jaycordaro/WES207/teensy/readme.md

# Teensy files
Arudino IDE sketches to be run on the Teensy board. Contains both demos and component tests.

## Usage:
Install the Teensy plug in for the Arduino IDE here:
https://www.pjrc.com/teensy/td_download.html

Each folder runs as a standalone project. They can be opened by selecting the ino file from the File > Open... window. The project can be flashed to the Teesny board by pressing the arrow button after selecting the Teensy board from the dropdown menu next to the arrow.
