jaycordaro/WES207/matlab/audio_upsampler/readme.md

# Audio Upsampler
Upsamples the 16ksps audio to 44.1ksps to be used by Teensy audio library.

## Usage:
Run the MATLAB script, it will play the upsampled audio and export it to a wav file.
