jaycordaro/WES207/matlab/oqpsk/readme.md

# OPQSK Modulator
Specification for a 802.15.4 OPQSK modulator. This is currently done on the Atmel board but could also be implemented on the FPGA.

## Usage:
Run oqpsk.m in Matlab.
