jaycordaro/WES207/teensy/demos/readme.md

# Teensy demos
This folder contains demos that constitute usable deliverables.

## Usage:
Each folder contains its own demo to be run in the Aruduino IDE.
