jaycordaro/WES207/matlab/bpsk/tx/readme.md

# BPSK Demodulator
Used to simulate modulation of the pulse-shaped BPSK.

## Usage:
Run tx_bpsk.m in Matlab. This will produce output samples in tx_out with can then be used in the rx simulation.
