jaycordaro/WES207/presentations/In-Person Presentation The Northernites.pptx.pdf

802.15.4 Project

## The Northernites

Sam Weismuller, SangRyul “Eric” Pae, Jay Cordaro

MAS 2023 Students UC San Diego

## Introduction

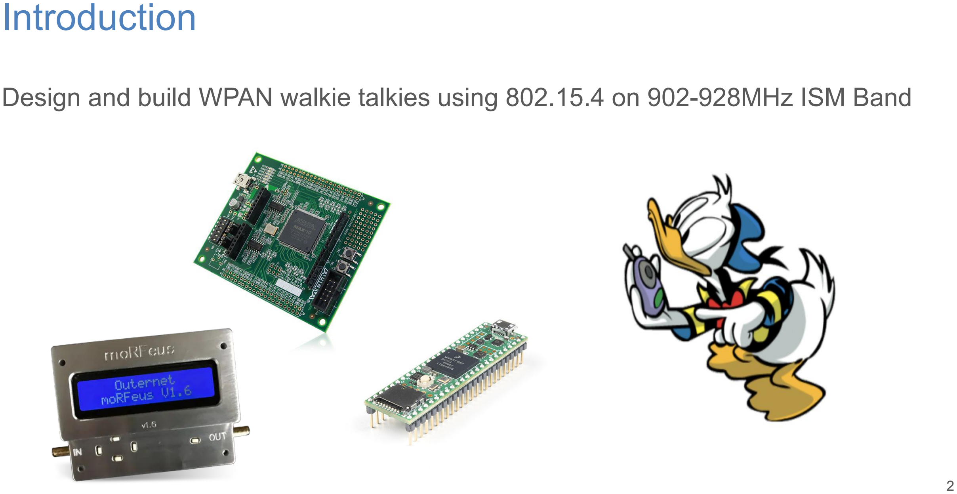
[picture p22: page 2]

Design and build WPAN walkie talkies using 802.15.4 on 902-928MHz ISM Band

### IEEE 802.15.4

- Simple standard to local-area networks
- Covers 900 MHz and 2.4 GHz ISM bands, among others
- Clause 13 defines Pulse-shaped BPSK and Clause 12 defines OQPSK mode
- Only Clause 13 BPSK is required in 900 MHz band
- Carrier-Sense Multiple Access with Collision Avoidance

Block Diagram

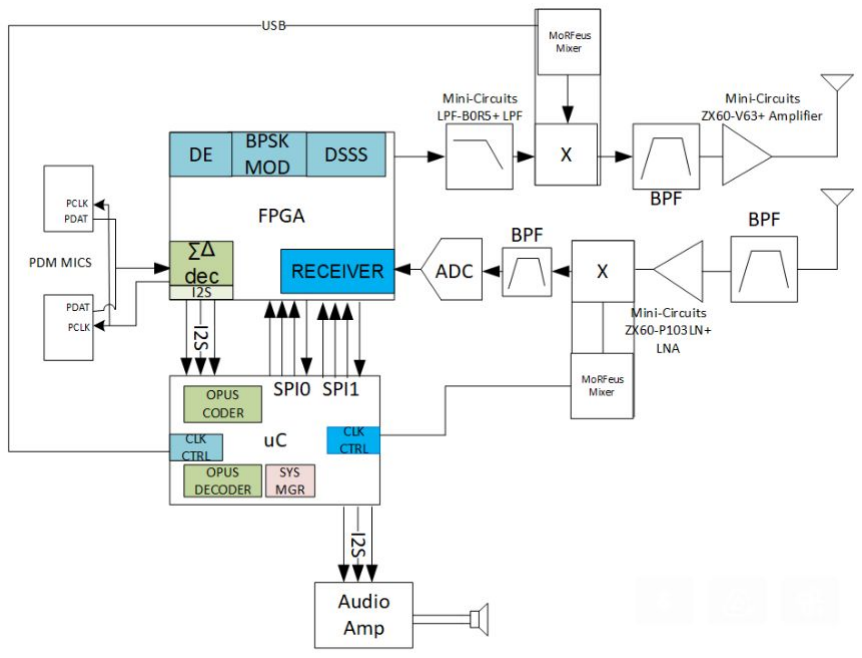
[picture p23: figure]

### Subsystems

- 3 subsystems:
- RF front end
- FPGA
- Microcontroller

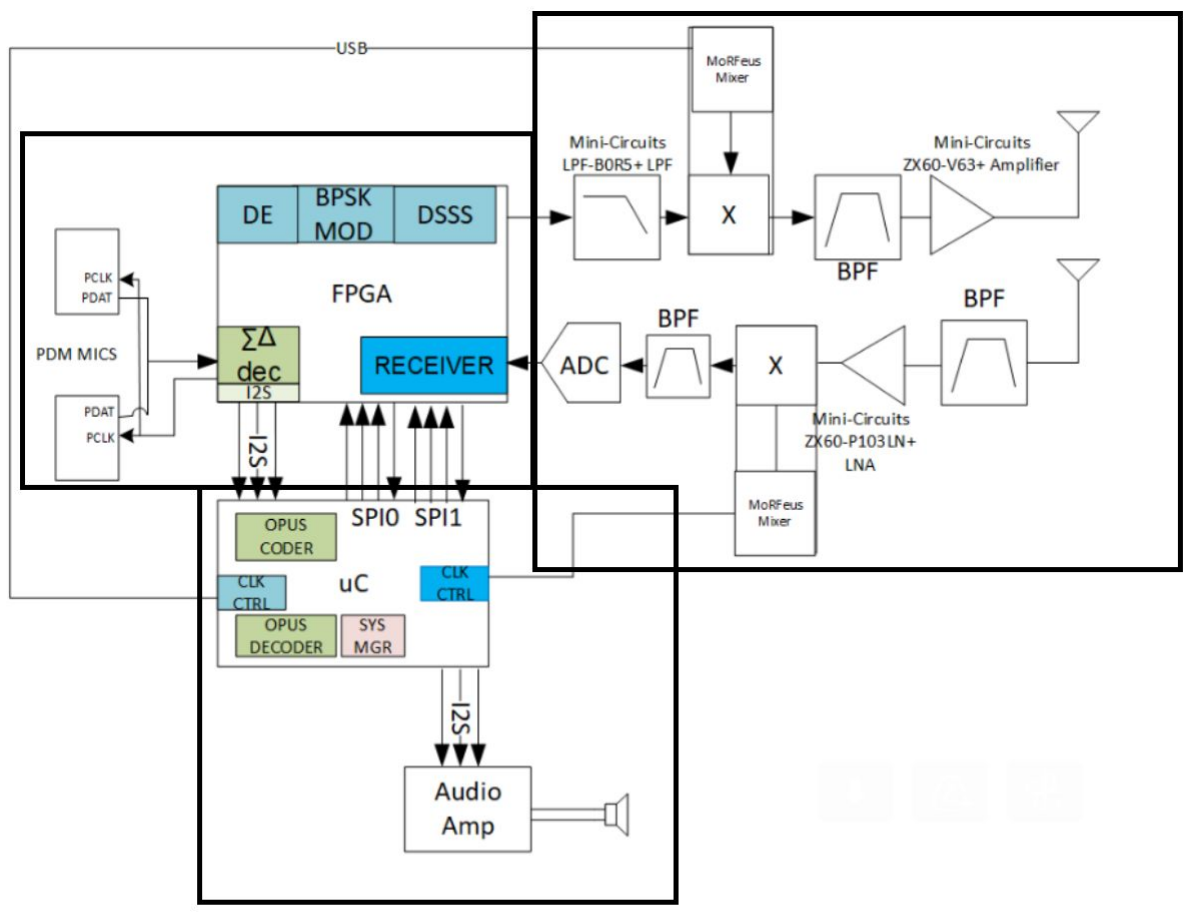
[picture p24: figure]

### Progress

Audio Front End/FPGA:

- Built floating point Matlab model of sigma-delta decimator, checked in (https://github.com/jaycordaro/WES207/tree/main/matlab/pdm)
- Captured PDM audio using test jig
- Wrote SystemVerilog code and test benches for SPI and I2S, checked in (https://github.com/jaycordaro/WES207/tree/main/rtl/audio_front_end)
- Floating point Matlab model of transmitter blocks, checked in (https://github.com/jaycordaro/WES207/tree/main/matlab/tx)
Microcontroller:
- Implemented Opus source coder demo reading/writing audio data from an SD card, checked in (https://github.com/jaycordaro/WES207/tree/main/teensy/encoder_test)
- Tested different bit error rates and code rates, checked in (https://github.com/jaycordaro/WES207/tree/main/matlab/opus_test)
RF Front End:
- Decision on RF front end scheme based on what we have.
- Parts search per general 802.15.4 required specification.
- comparison required comp. spec vs. reference device`s comp spec vs. available components spec. checked in (https://docs.google.com/spreadsheets/d/19H6ZIEb3O8uK-xjuLmNXYiP_aB71ofQJ7XaVfCivGWU/edit)
- List up affordable parts to order: compromise between cost vs. demo level.

802.15.4 Project

## Audio Front End

### PDM Microphones

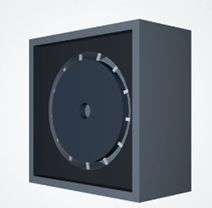
[picture p25: figure]

Analog MEMS microphones
- Sound pressure moves a micromechanical plate which causes a change in capacitance
- Noise sensitive
- | Difficult to route --need analog supply, ferrite bead and | short differential
| trace between microphone and host
- Lower power
- Cheaper
Pulse Density Modulation MEMS microphones
- Uses same MEMS sensor but converts analog voltage into digital inside the mic using sigma delta modulation
- Robust to interference
- Simpler to design-in – longer trace possible, beamforming, etc.
- Two microphones on same DAT trace (single bit dual data rate)
- High power (recent PDM microphones are much lower power, however)

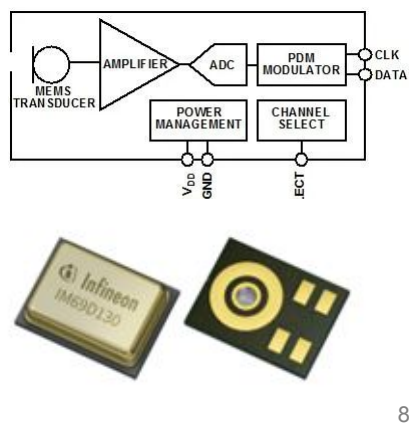
[picture p26: figure]
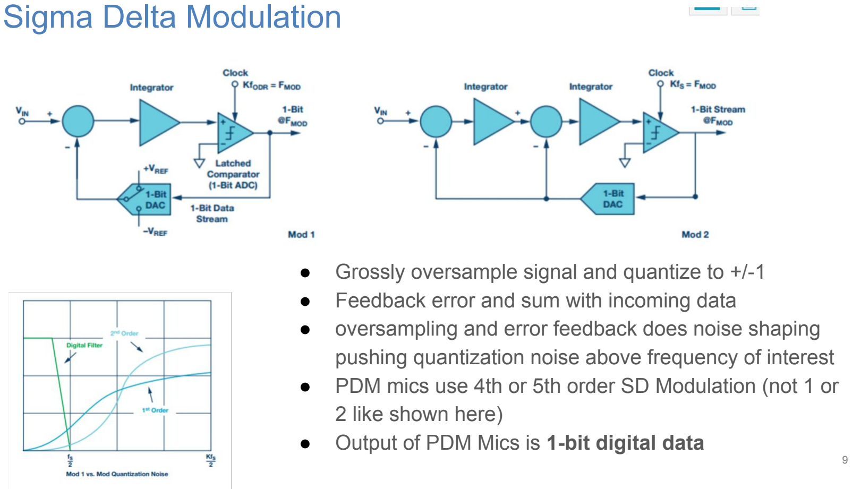
[picture p27: page 9]

### Sigma Delta Modulation

- Grossly oversample signal and quantize to +/-1
- Feedback error and sum with incoming data
- oversampling and error feedback does noise shaping pushing quantization noise above frequency of interest
- PDM mics use 4th or 5th order SD Modulation (not 1 or 2 like shown here)
- Output of PDM Mics is 1-bit digital data

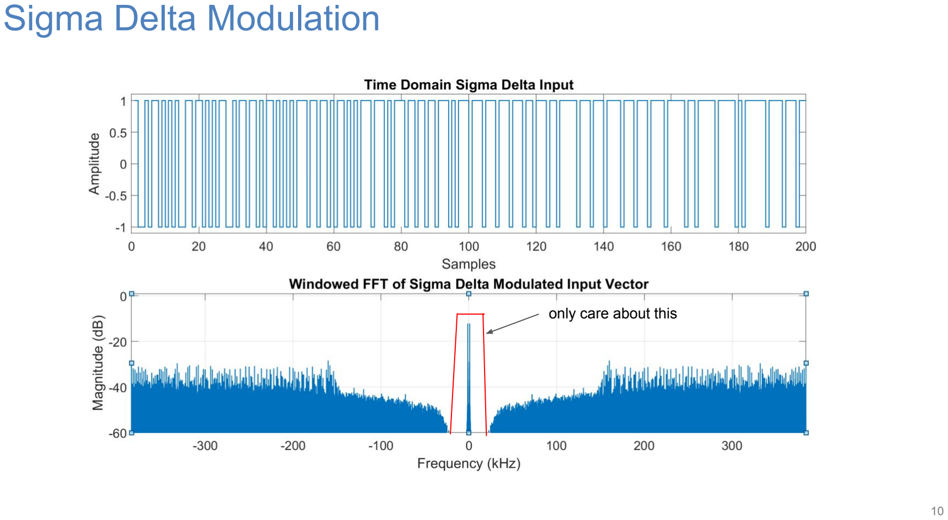
[picture p28: page 10]

### Sigma Delta Modulation

only care about this

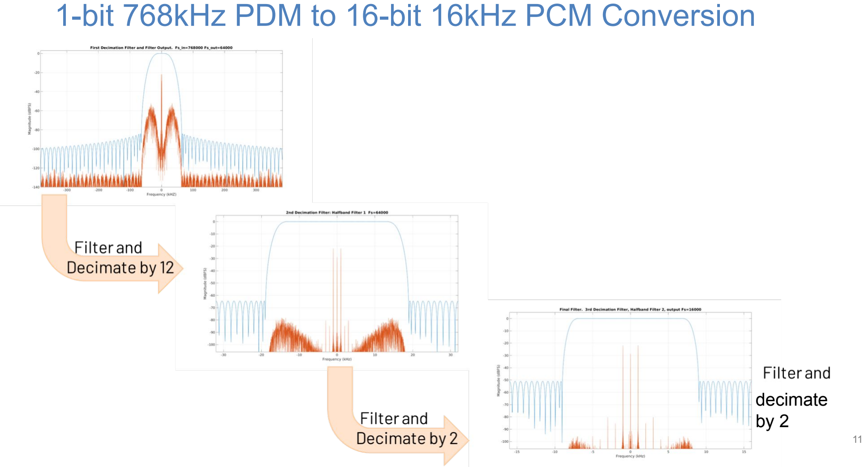
[picture p29: page 11]

### 1-bit 768kHz PDM to 16-bit 16kHz PCM Conversion

decimate
by 2

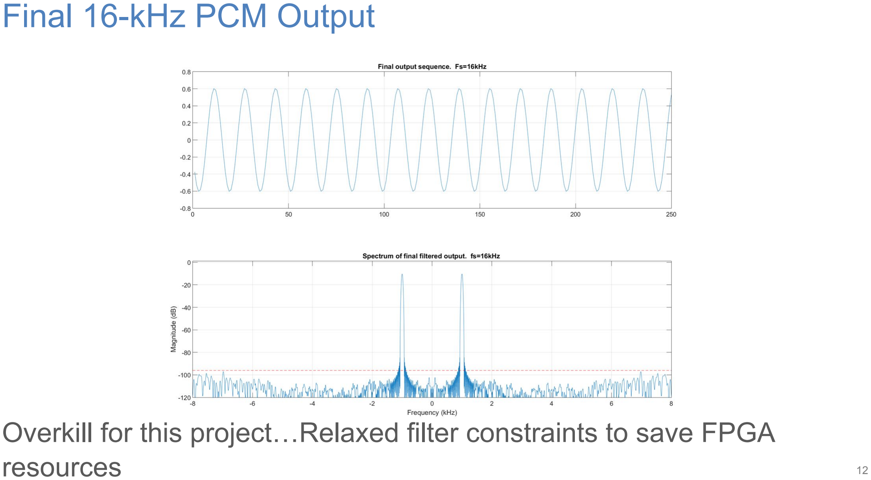
[picture p30: page 12]

### Final 16-kHz PCM Output

Overkill for this project…Relaxed filter constraints to save FPGA resources

### PDM Filtering and Decimation

- Could brute force it (about 300 Taps)
- CIC Filter followed by 2 stages of half-band filters is typical
- Can do multi-stage half-band, IIR, all kinds of things
- Fred Harris suggested using a polyphase filter. Optimum for FPGAs.

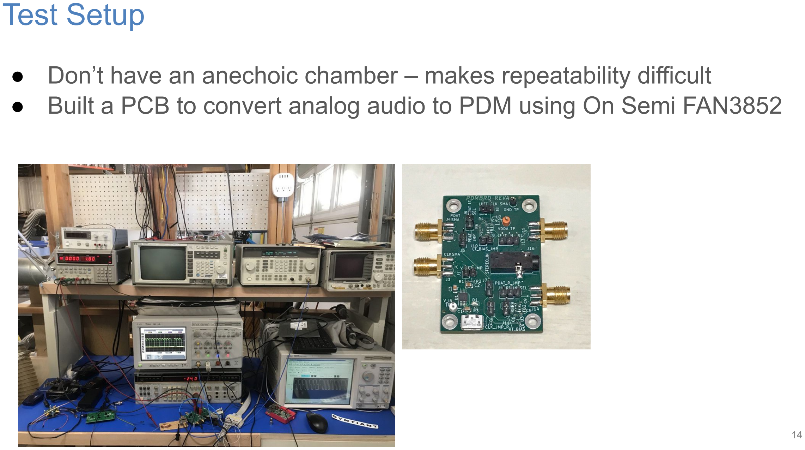
[picture p31: page 14]

### Test Setup

- Don’t have an anechoic chamber – makes repeatability difficult
- Built a PCB to convert analog audio to PDM using On Semi FAN3852

### Audio Test Decimate by 12 using 36 or 48 taps in 1st stage

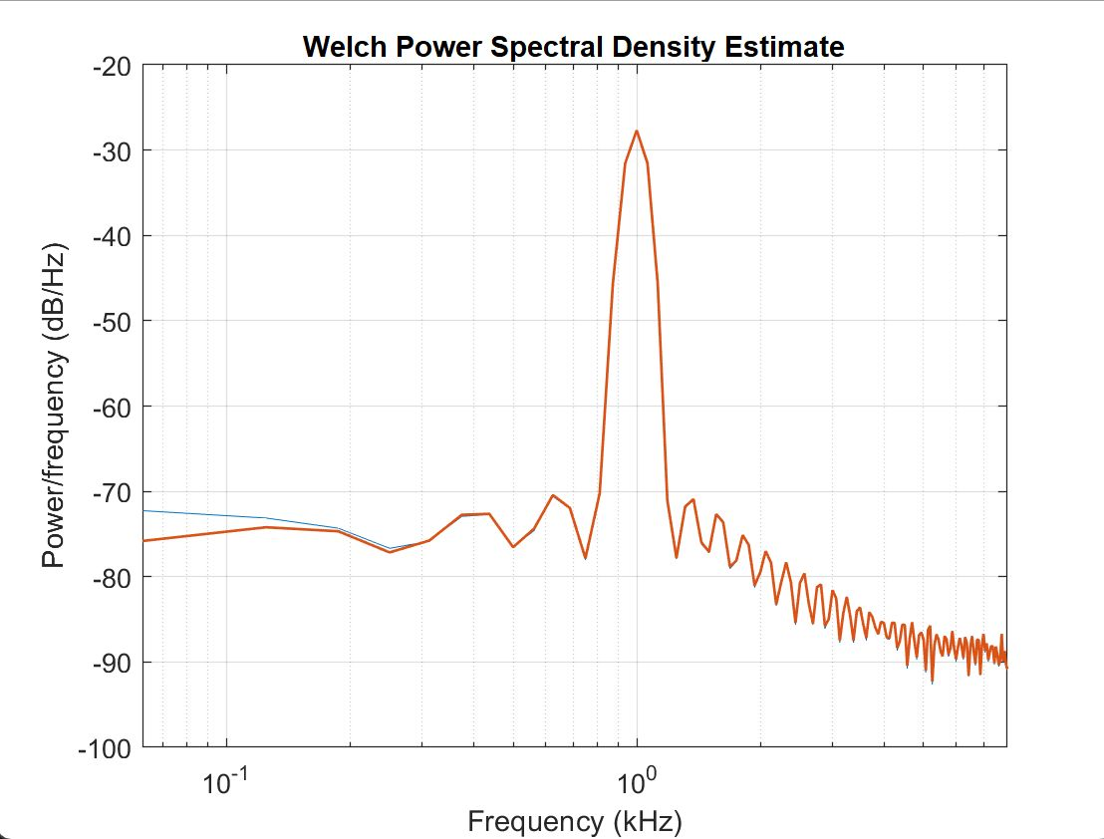
[picture p32: figure]

- 50dB attenuation in 1st stage
- 36 Taps in 1st stage
- Fewer taps
- quantization noise audible

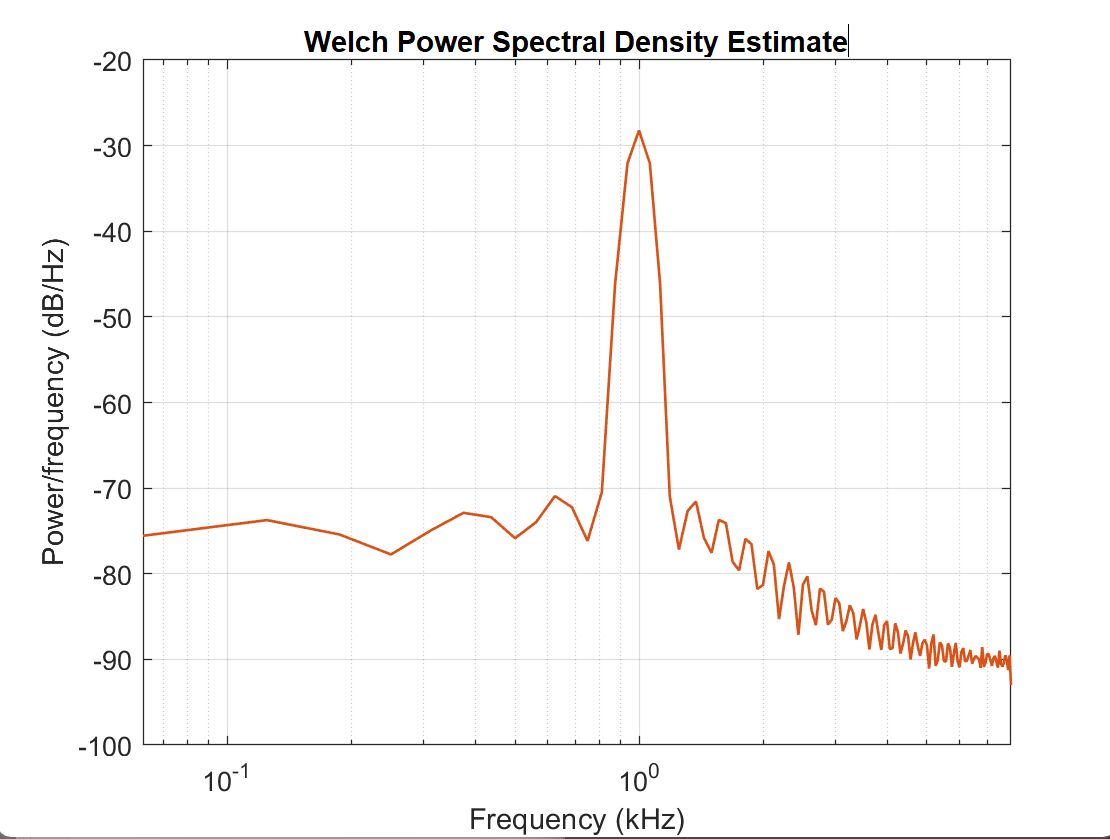
[picture p33: figure]

- 60dB attenuation
- 48 Taps in 1st stage
- Less quantization noise

### Implementation

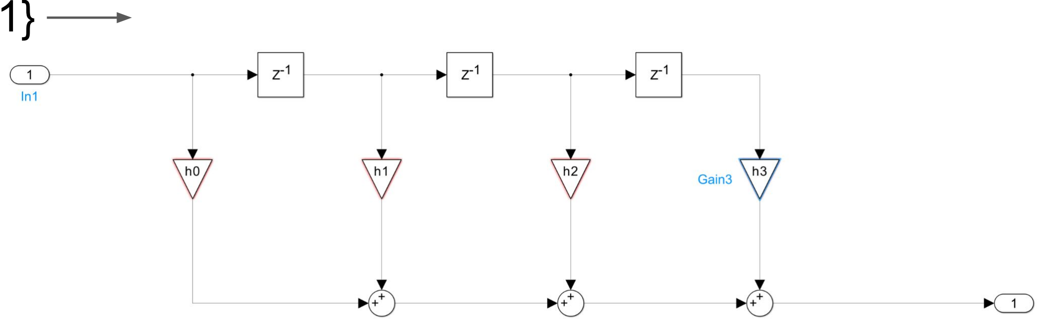
[picture p34: figure]

for jj=2:decimation_rate
x_poly(jj,:)=[0 x(decimation_rate-jj+2:decimation_rate:end)]; end

for ll=1:decimation_rate
y_poly_dec_leg(ll,:)=filter(poly_hh(:,ll),1,x_poly(ll,:)); end
y_poly_dec=sum( y_poly_dec_leg([1:size(y_poly_dec_leg,1)],:));
- One polyphase leg shown with standard FIR structure
- Could certainly implement with this structure in an FPGA
- Note that input vector to filter can be only be 16 values:
- [ 1 1 1 1]
- [-1 1 1 1]
- [ 1 -1 1 1]
- …
- [-1 -1 -1 -1]

{-1..1}

### Polyphase Coefficients

- Coefficients in each leg are mirrored and flipped
- Only store ½ the coefficients

poly_hh =

-0.0002 | -0.0005 | -0.0009 | -0.0016 | -0.0024 | -0.0034 | -0.0045 | -0.0054 | -0.0060 | -0.0060 | -0.0050 | -0.0029
0.0006 | 0.0057 | 0.0125 | 0.0207 | 0.0302 | 0.0405 | 0.0510 | 0.0612 | 0.0704 | 0.0780 | 0.0834 | 0.0862
0.0862 | 0.0834 | 0.0780 | 0.0704 | 0.0612 | 0.0510 | 0.0405 | 0.0302 | 0.0207 | 0.0125 | 0.0057 | 0.0006
-0.0029 | -0.0050 | -0.0060 | -0.0060 | -0.0054 | -0.0045 | -0.0034 | -0.0024 | -0.0016 | -0.0009 | -0.0005 | -0.0002

### High Pass Filter

- After decimation, add a 1st order high pass filter for DC offset

●

- gives a filter corner of ~ 80Hz
- human ear doesn’t care about nonlinear phase at low freq + cleans up voice quality a little

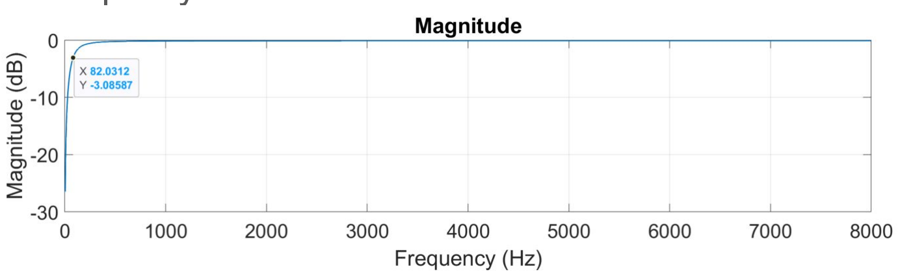
[picture p35: figure]

### PSD comparison of Decimated Output With/Without HPF

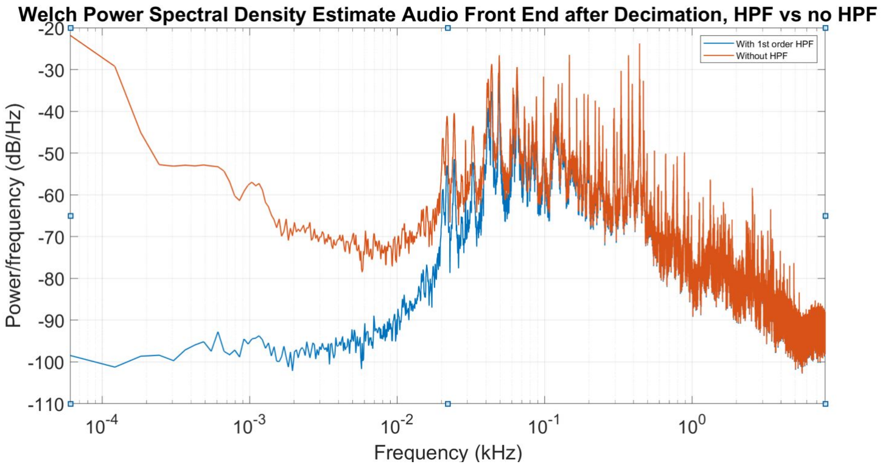
[picture p36: figure]

I2S

- I2S is a Philips (now NXP) standard from 1990s.
- Widely used in Audio
- 3 pins:

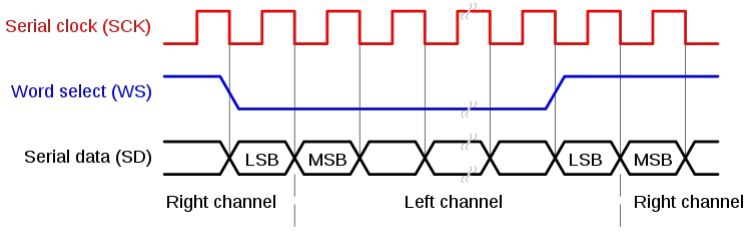
[picture p37: figure]

- FPGA will be I2S Target, Teensy will be I2S Controller | 20

### Simulink Model of Audio Front End and FPGA Top Level

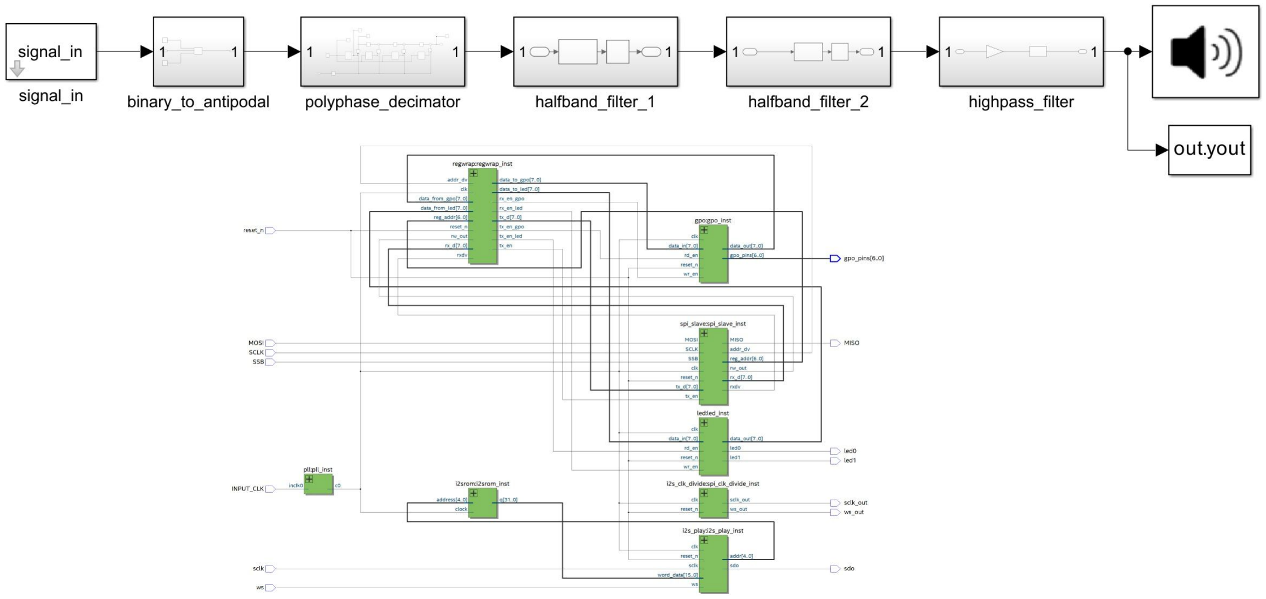
[picture p38: figure]

FPGA ● Implements ○ | SPI interfaces to uC ○ | PDM decimator, I2s to uC ○ | BPSK modulation and pulse shaping ○ | TX to DDS ○ | input from ADC ○ | Demodulation ○ | Demodulated bits to uC ● Intel 10M08 EVB ○ | 55nm ○ | 13 pins low-speed I/O ○ | 18 pins high-speed single ended I/O + 15

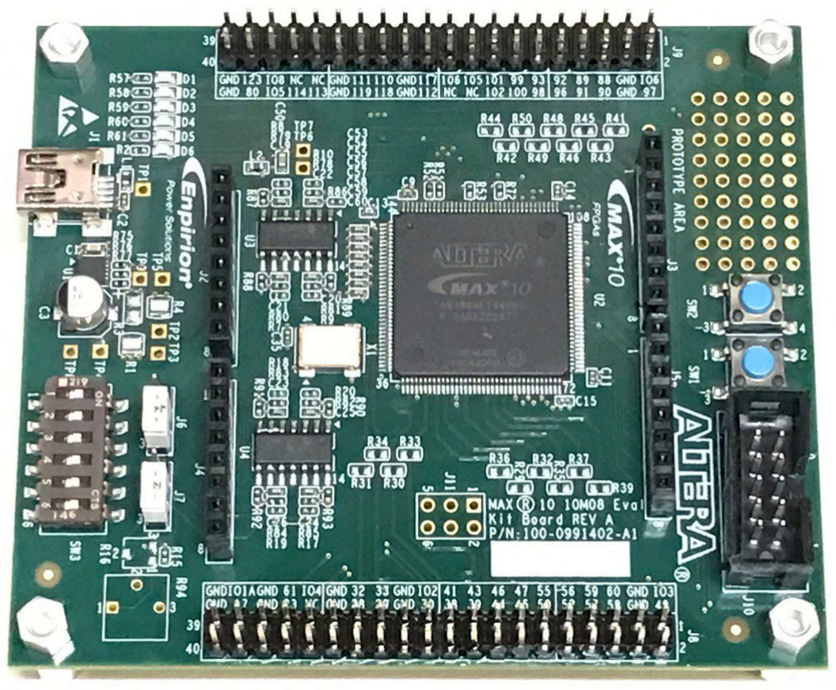
[picture p39: figure]

differential I/O
- | 24 18x18 DSP blocks ○ | $50

### Future Work

FPGA:

- Implement Sigma Delta decimator in FPGA. Send out I2S, check waveform
- Implement BPSK modulator in FPGA. Check digital waveform using Logic Analyzer. vector match
- RX Input from ADC
- Demodulator
Integration:
- Connect Microcontroller to FPGA. Read and write FPGA registers via SPI
- Validate I2S from FPGA

802.15.4 Project

## Microcontroller

### Teensy 4.1

- ARM Cortex-M7 at 600 MHz
- Float point math unit, 64 & 32 bits
- 7936K Flash, 1024K RAM
- 2 I2S, 3 SPI
- SD card slot
- $30!

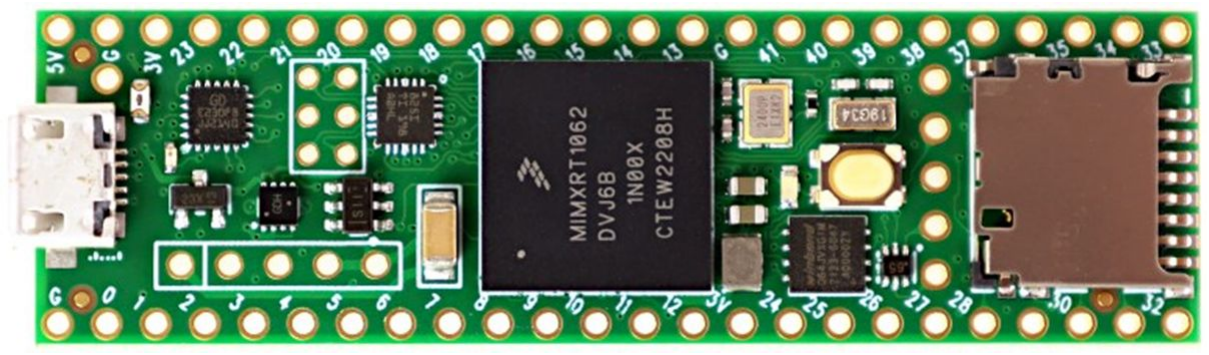
[picture p40: figure]

### Development Environment

- “Teensyduino” plug in for Arduino IDE
- Supports Arduino built-in functions and serial monitor
- Teensy loader application can directly load binaries without the IDE

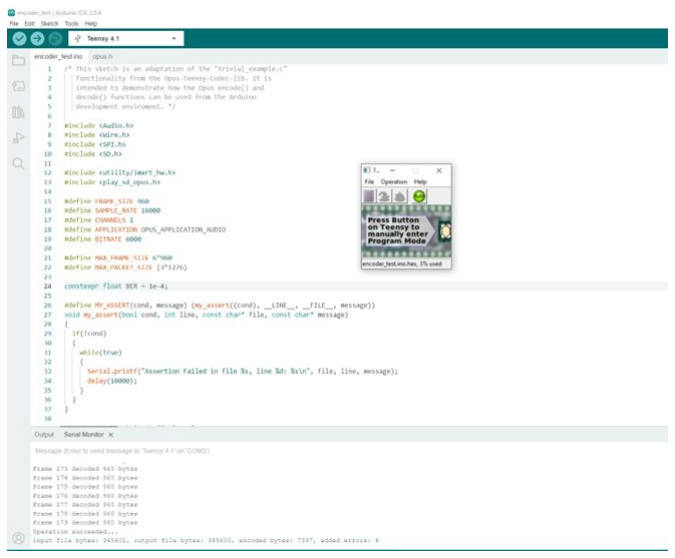
[picture p41: figure]

### Opus Codec

- Open-source audio source coder used by Skype
- One of the best source coders available
- Encoder input and decoder output is 16-bit Pulse Code Modulation data
- Encoded bit rates as low as 6kbps
- Input sample rates as low as 8kbps

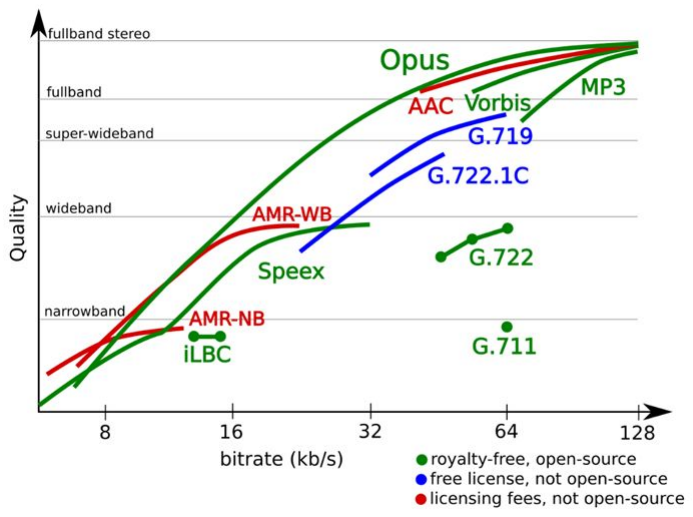
[picture p42: figure]

### Opus Library for Teensy

- The Arduino-Teensy-Codec-lib has an open-source implementation of the Opus Codec for the Teensy
- It allows you to specify the encoded bit rate and input/output sample rates
- Library is designed for packetization, allowing you specify your desired packet size for each iteration of the encoder

### Opus Demo

- Uses Matlab to generate 16-bit PCM binary files from Jay’s PDM to PCM demo or from a wav file
- Input binary is saved to a SD card and put in Teensy’s SD card slot
- Teensy reads the input binary, encodes it, injects bit errors, decodes it, and then saves the output to a new binary file
- Output binary is read by Matlab and converted to wav file
- This allows us to test the quality of the audio at different encoded bit rates and BERs!

### Opus Demo Results (Speech)

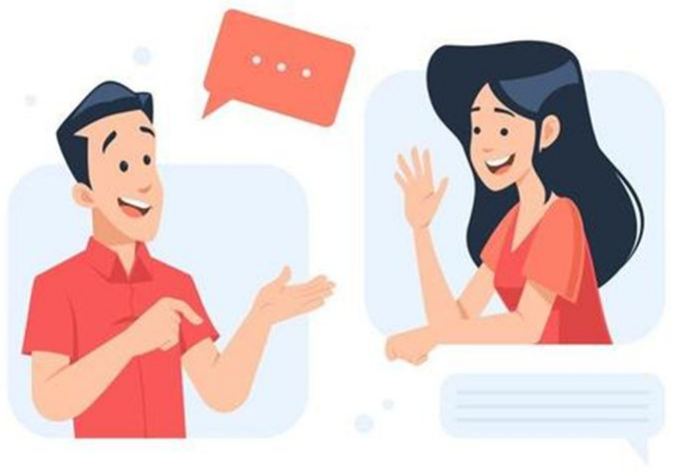
[picture p43: figure]

- 6000 bps:
- BER 0:
- BER 1e-4:
- 12000 bps:
- BER 0:
- BER 1e-4:

### Opus Demo Results (Music)

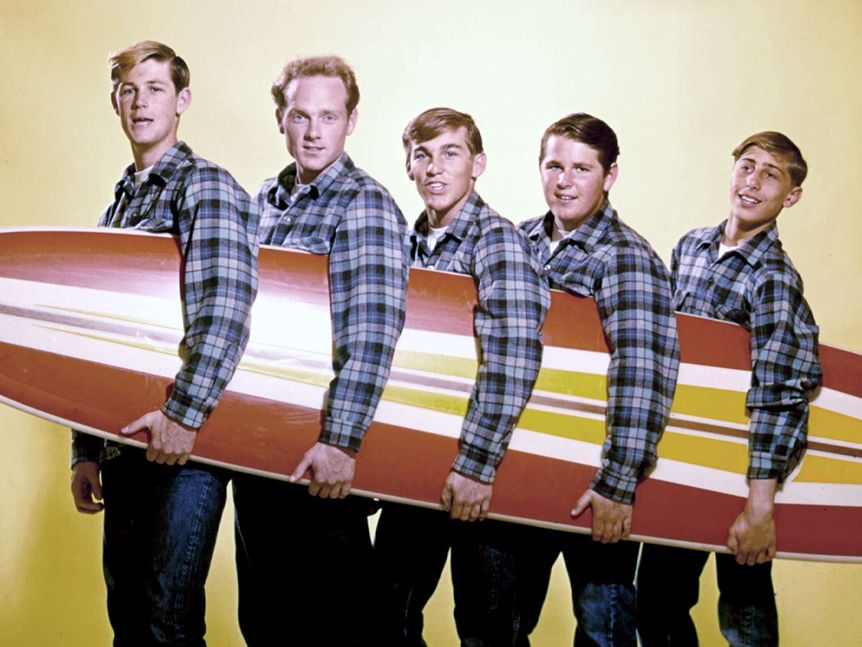
[picture p44: figure]

- 6000 bps:
- 12000 bps:
- 16000 bps:
- 12000 bps:
- BER 1e-4:
- BER 1e-3:

### Demo Takeaways

- 12000 kbps is suitable for most audio
- Effect of BER is similar at different levels of compression
- The quality for non-speech audio is worse at higher levels of compression than for speech audio

### Future Work

- I2S and SPI interface to FGPA, want to get working ASAP
- I2S interface to output speaker, may use the Teensy Audio shield board
- Packetizing opus decoder output into 802.15.4 packets

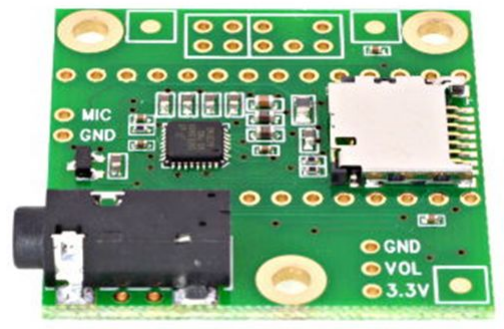
[picture p45: figure]

802.15.4 Project

## RF Front End + Mixed signal

### Block Diagram

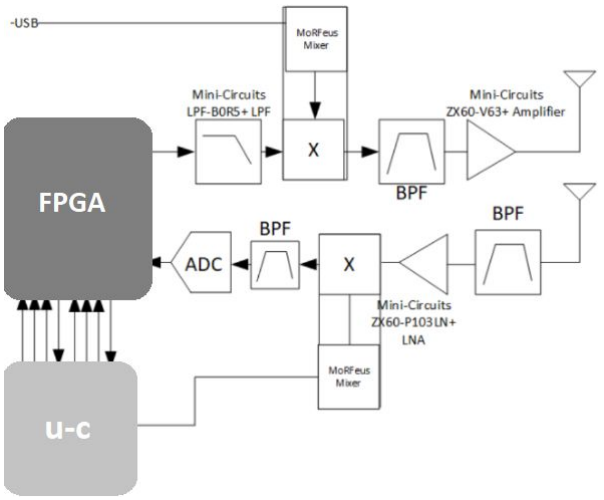
[picture p46: figure]

Modulation and Spreading

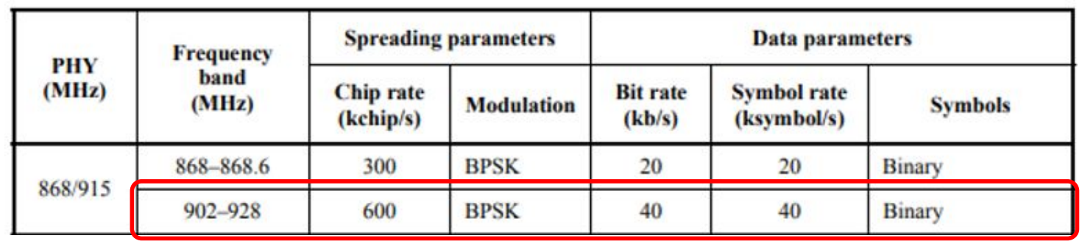
[picture p47: figure]

- no IQ modulator demodulator
- no AGC

# TRX

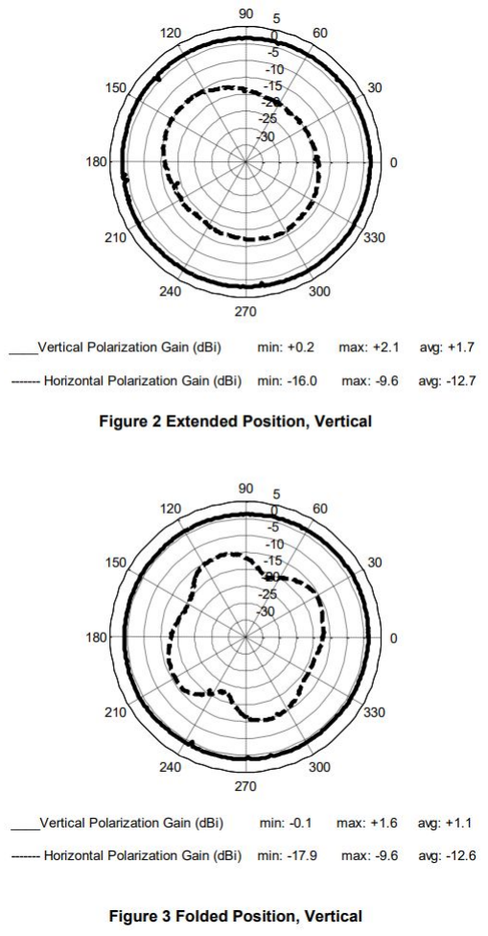
[picture p48: figure]

- Frequency range: 902-928 MHz (US)
- Gain: typically 2-5 dBi
- Polarization: linear or circular
- Radiation pattern: omnidirectional or

directional

- Connector: typically SMA or u.FL

### Antenna

RX

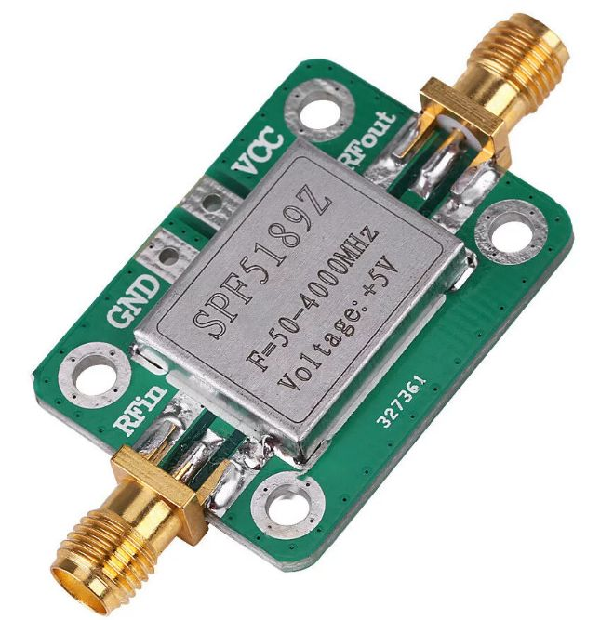
[picture p49: figure]

SPF5189

- RF Low Noise Amplifier
- Freq: 50-4000MHz
- Gain : ~17dB
- NF: 0.6dB

### LNA

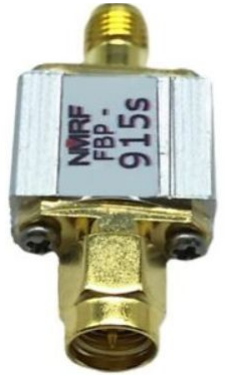
[picture p50: figure]

FBP-915s

- Impedance:50 ohms
- Center frequency:915MHz
- Passband:902～928MHz
- Band Insertion Loss:<2.5 dB
- Out-of-band isolation: > 40 dB @ 815 MHz and 1015 MHz
- Maximum load power:300 mW (25 dBm)
- Interface:SMA-M, SMA-F

### Rx RF BPF

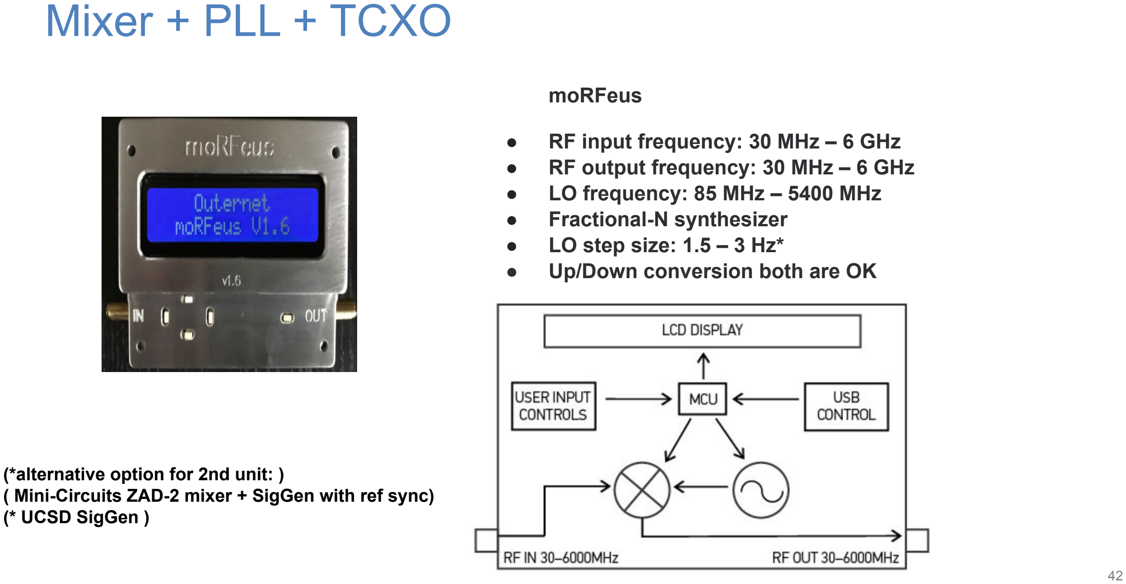
[picture p51: figure]
moRFeus; ● RF input frequency: 30 MHz – 6 GHz ● RF output frequency: 30 MHz – 6 GHz ● LO frequency: 85 MHz – 5400 MHz ● Fractional-N synthesizer ● LO step size: 1.5 – 3 Hz* ● Up/Down conversion both are OK; Mixer + PLL + TCXO; (*alternative option for 2nd unit: ); (* UCSD SigGen )

( Mini-Circuits ZAD-2 mixer + SigGen with ref sync)

### Rx IF filter

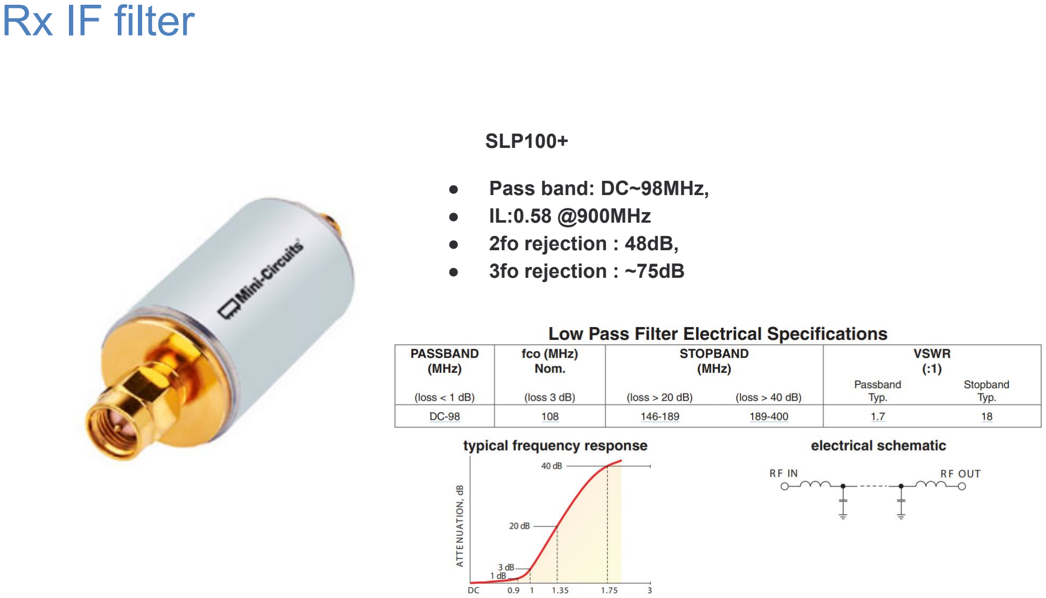
[picture p52: page 43]

SLP100+

- Pass band: DC~98MHz,
- IL:0.58 @900MHz
- 2fo rejection : 48dB,
- 3fo rejection : ~75dB

### ADC

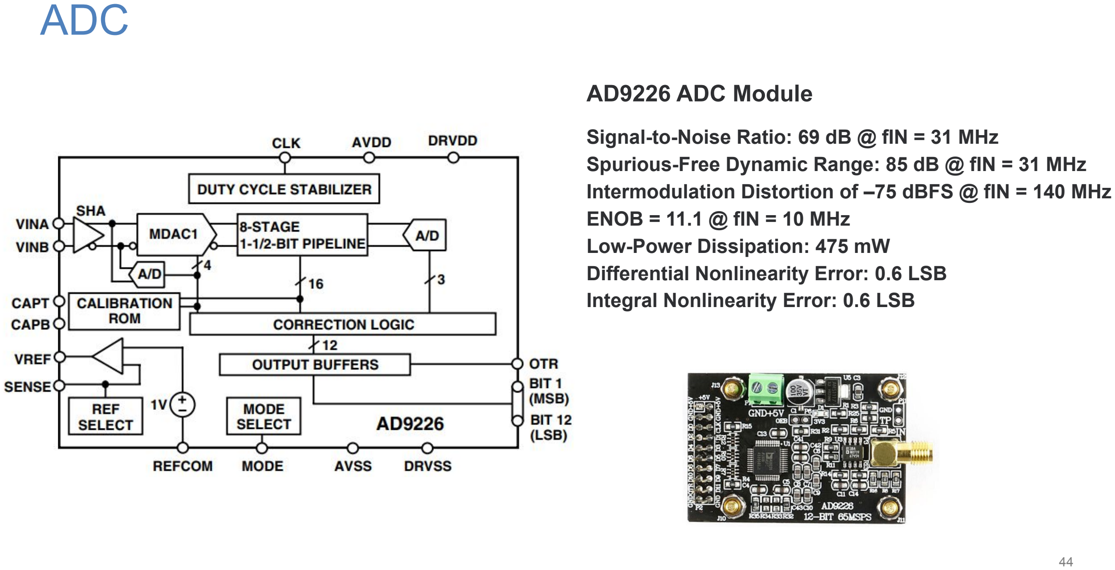
[picture p53: page 44]

AD9226 ADC Module

- Signal-to-Noise Ratio: 69 dB @ fIN = 31 MHz
- Spurious-Free Dynamic Range: 85 dB @ fIN = 31 MHz
- Intermodulation Distortion of –75 dBFS @ fIN = 140 MHz
- ENOB = 11.1 @ fIN = 10 MHz
- Low-Power Dissipation: 475 mW
- Differential Nonlinearity Error: 0.6 LSB
- Integral Nonlinearity Error: 0.6 LSB

TX

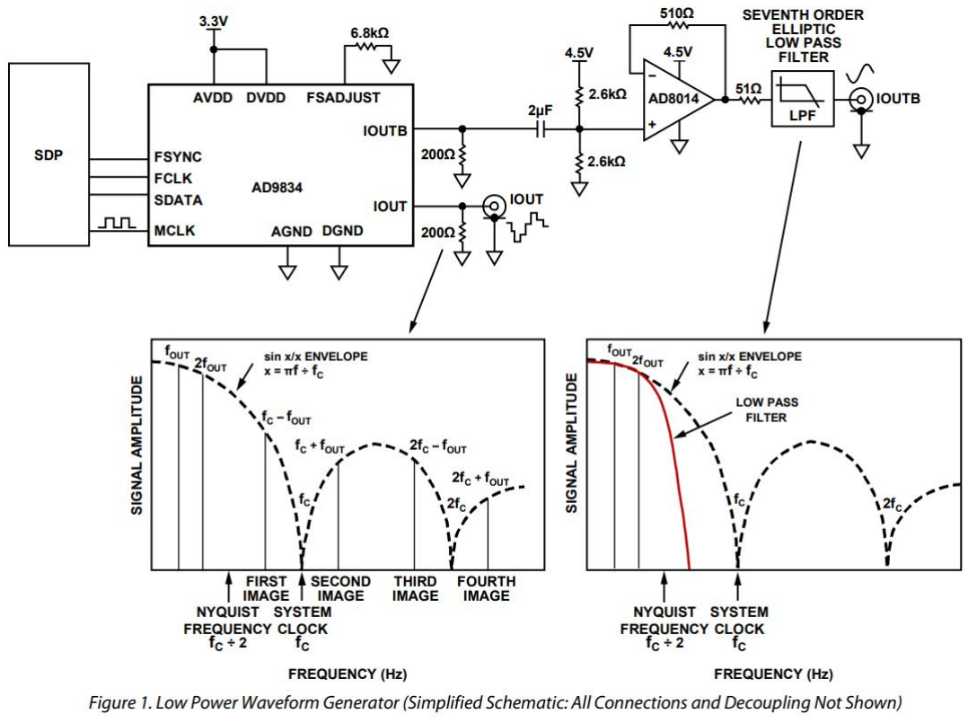
[picture p54: figure]

### DDS

### Functional Block Diagram

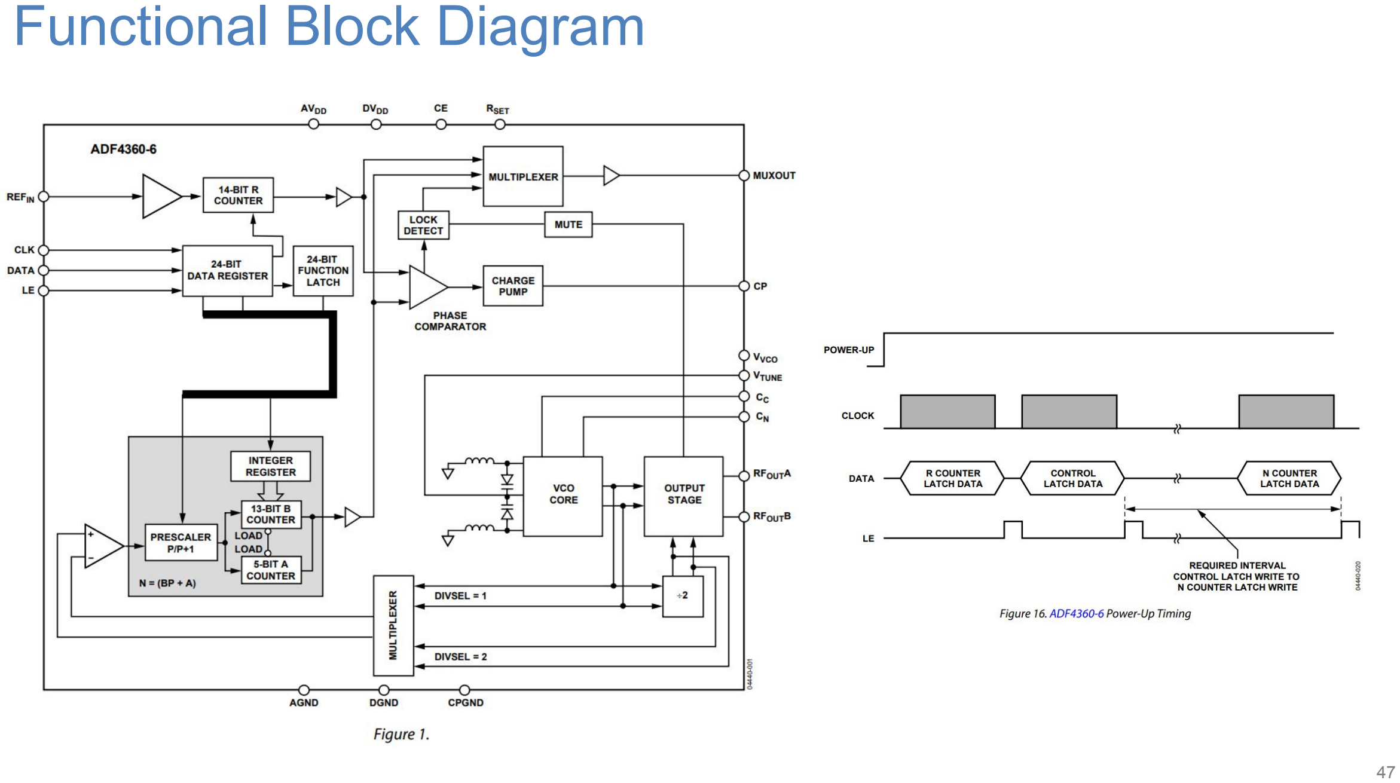
[picture p55: page 47]

### DDS

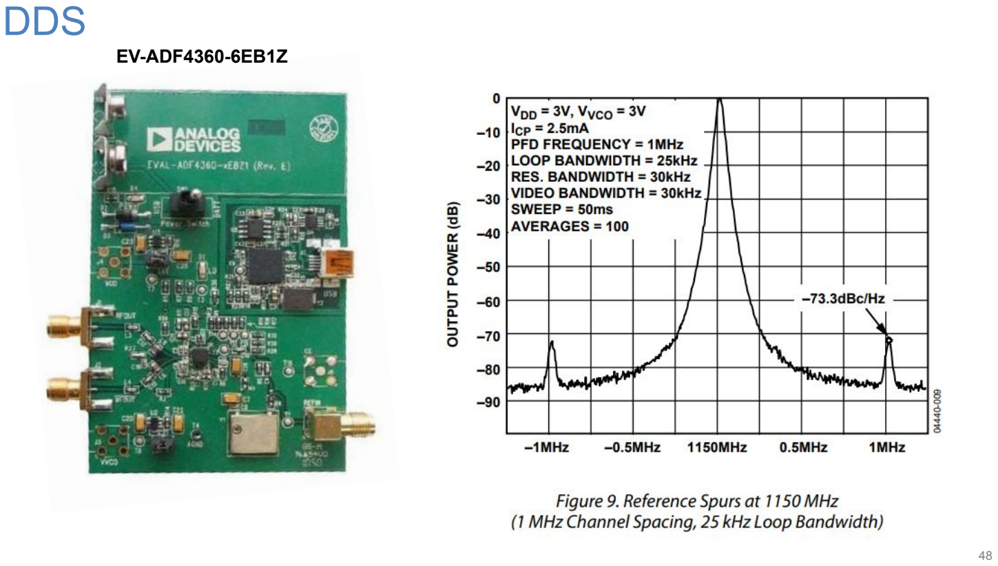
[picture p56: page 48]

EV-ADF4360-6EB1Z

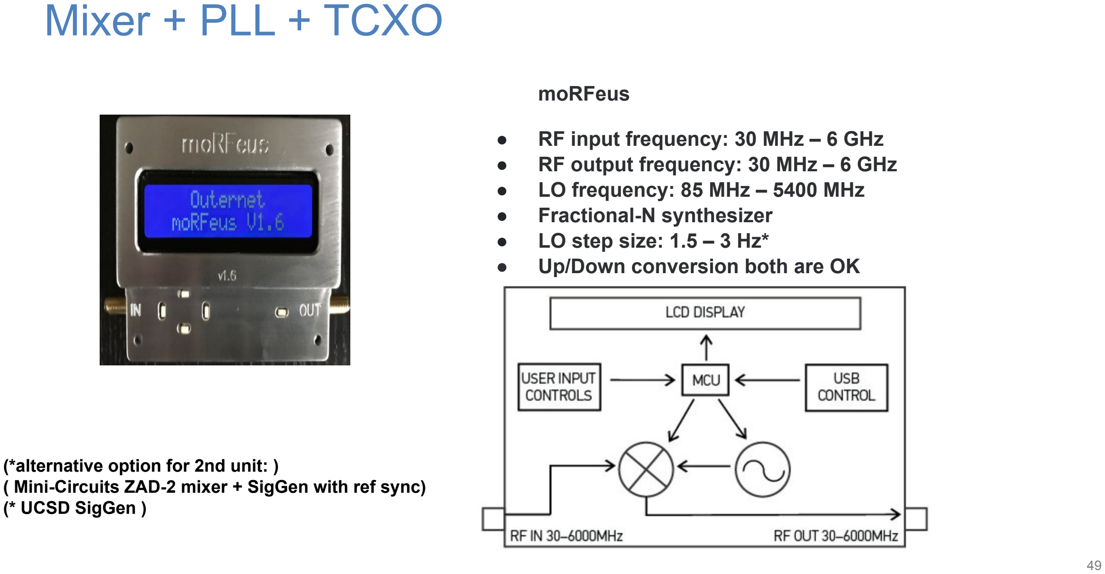
[picture p57: figure]
moRFeus; ● RF input frequency: 30 MHz – 6 GHz ● RF output frequency: 30 MHz – 6 GHz ● LO frequency: 85 MHz – 5400 MHz ● Fractional-N synthesizer ● LO step size: 1.5 – 3 Hz* ● Up/Down conversion both are OK; Mixer + PLL + TCXO; (*alternative option for 2nd unit: ); (* UCSD SigGen )

( Mini-Circuits ZAD-2 mixer + SigGen with ref sync)

PA

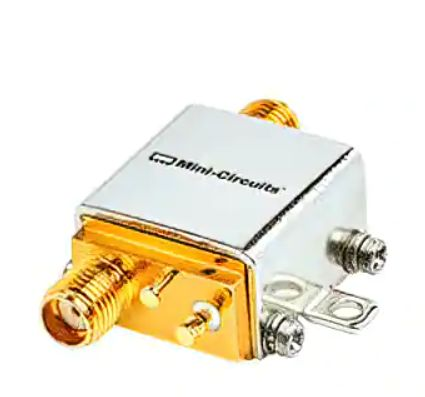
[picture p58: figure]

ZX60-V63+

- Frequency: 50MHz ~ 6GHz
- P1dB : 18.5dBm
- Gain : 15.4dB
- Noise Figure : 4.3dB
- Voltage - Supply : 4.8V ~ 5.2V
- Current - Supply : 69mA
- SMA Connectors

### RF Frontend + Mixed signal parts list

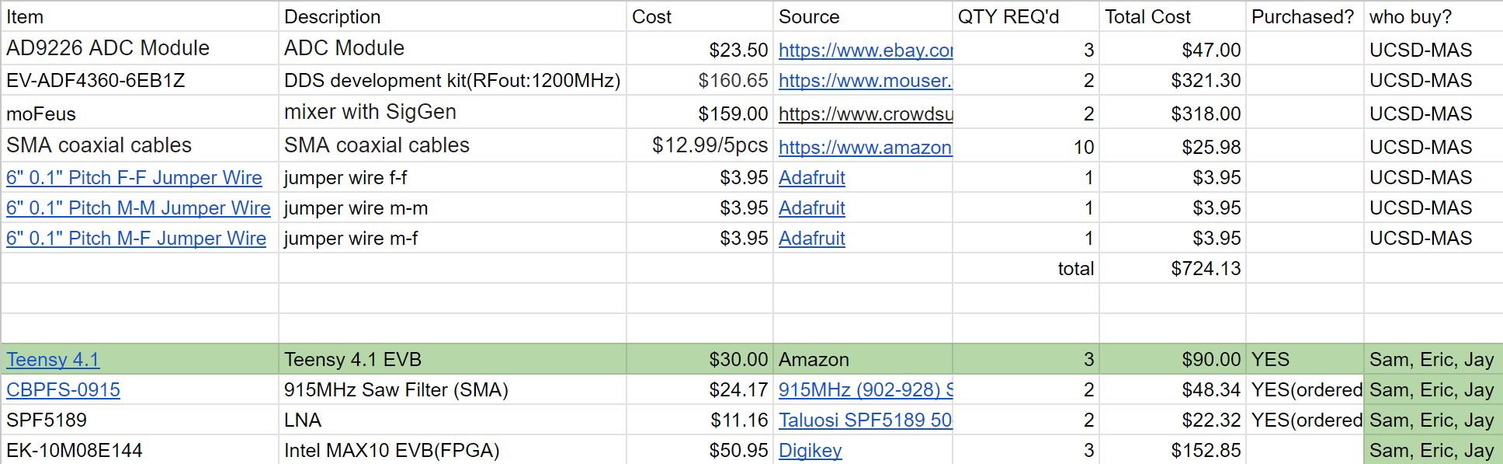
[picture p59: figure]

### Future work

- Link budget analysis : range vs. BER
- RF Frontend + chanel model with Simulink for timing recovery simulation of baseband.
- Rx/Tx chain integration and performance test.
- Mixed signal part & FPGA interoperability test.
- Troubleshooting for whole system operation.
