jaycordaro/WES207/matlab/opus_test/readme.md

# Opus output/input generator
Used for generating PCM files or reading PCM files in order to test the Opus encoding/decoding functionality of the Teensy.

## Usage:
Generate Teensy test input:
wav_to_pcm.n - converts .wav files into PCM .bin files

Read Teensy test output:
audio_playback.m - converts .bin PCM files into wav files and plays them back
