jaycordaro/WES207/teensy/tests/playthrough_pdm/readme.md

# Playthrough PDM
Record play audio from the microphone out through the speaker.

## Usage:
Connect the Teensy to the ADC, microphone, DAC, and speaker and then tun the sketch in the Arduino IDE.
