jaycordaro/WES207/teensy/tests/record_pdm/readme.md

# Record PDM
Record audio from the microphone to a file and downsample by 3.

## Usage:
Connect the Teensy to the ADC and microphone and insert an SD card into the Teensy. Run the sketch in the Arduino IDE and enter the "rec" command and speak into the microphone.
