jaycordaro/WES207/teensy/tests/audio_to_speaker/readme.md

# Audio to speaker
Upsamples and plays a 16-bit 16ksps audio file out of the speaker.

## Usage:
Connect the Teensy to the Speaker, load the input file as Input.bin onto an SD and insert into the Teensy. Run the sketch in the Arduino IDE and then enter the "play" command on the serial monitor.
