jaycordaro/WES207/teensy/tests/audio_sample_player/readme.md

# Audio Sample Player
Cycles through playing several audio buffers in order to test the speaker.

## Usage:
Connect the Teensy to the DAC and Speaker and then run the sketch in the Arduino IDE.
