jaycordaro/WES207/teensy/tests/spi_test/readme.md

# SPI Test
Used to test the SPI interface to the RF board.

## Usage
Connect the Teensy to the RF board. Then use the "read" and "write" commands to read or write a specific register.
