jaycordaro/WES207/teensy/tests/oqpsk/readme.md

# OQPSK Test
Tests OPQSK Tx and Rx using the SPI interface to the RF board.

## Usage:
Connect the RF board to the Teensy. Run the "tx" command to initiate a transmit. Run the "rx" command to wait for a receive. Use the "read_rx" command to print the receive results.
