jaycordaro/WES207/teensy/tests/simple_serial_test/readme.md

# Simple Serial Test
Verfies the serial connection is working to the Teensy.

## Usage:
Run the sketch, then go to Tools > Serial Monitor on the Arduino IDE. You should be text being output into the monitor window.
