jaycordaro/WES207/teensy/tests/rf_test/readme.md

# RF Test
Tests connectivity to the RF board by outputting a carrier wave in channel 1 of the 802.15.4 915 MHz band.

## Usage:
Connect the RF board to the Teensy and then run the sketch. The output can be verified on a spectrum analyzer.
