jaycordaro/WES207/teensy/tests/audio_from_fpga/readme.md

# Audio from FPGA
Tests receiving audio data from the Tx audio FIFO on the FPGA via SPI.

## Usage:
Connect the Teensy to the FPGA and insert an SD card before running the sketch.
