jaycordaro/WES207/teensy/tests/encoder_test/readme.md

# Encoder Test
Tests the Opus encoder by reading a audio file, encoding it, decoding it, and writing the audio to a new file.

## Usage:
Load Input.bin onto an SD card and insert into the Teensy before loading the sketch.
