jaycordaro/WES207/rtl/WES207_basic/rtl/regwrap.sv

/*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
	1. Redistributions of source code must retain the above copyright notice, 
	this list of conditions and the following disclaimer.

	2. Redistributions in binary form must reproduce the above copyright notice, 
	this list of conditions and the following disclaimer in the documentation 
	and/or other materials provided with the distribution.

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
	handles the mux/demux of registers throughout the design to the spi_slave block

*/
module regwrap(
		input logic clk,
		input logic reset_n,
		output logic rx_en_gpo,
		output logic rx_en_status,
		output logic input_en_tx_packet_len,
		output logic input_en_tx_packet,
		output logic input_en_rx_packet_len,
		output logic input_en_rx_packet,
		output logic rx_en_led,
		output logic rx_en_dac,
		output logic rx_en_fifo,
		output logic rx_en_fifo_length,
		output logic tx_en_gpo,
		output logic tx_en_status,
		output logic output_en_tx_packet_len,
		output logic output_en_tx_packet,
		output logic output_en_rx_packet_len,
		output logic output_en_rx_packet,
		output logic tx_en_led,
		output logic tx_en_dac,
		output logic tx_en_fifo,
		output logic tx_en_fifo_length,
		output logic [7:0] tx_d,
		input logic [6:0] reg_addr,
		input logic addr_dv,
		input logic rxdv,
		input logic rw_out,
		input logic [7:0] rx_d,
		input logic [7:0] data_from_gpo,
		input logic [7:0] data_from_status_reg,
		input logic [7:0] data_from_tx_packet_len_reg,
		input logic [7:0] data_from_tx_packet_reg,
		input logic [7:0] data_from_rx_packet_len_reg,
		input logic [7:0] data_from_rx_packet_reg,
		input logic [7:0] data_from_led,
		input logic [7:0] data_from_dac,
		input logic [7:0] data_from_fifo,
		input logic [7:0] data_from_fifo_length,
		output logic [7:0] data_to_gpo,
		output logic [7:0] data_to_status_reg,
		output logic [7:0] data_to_tx_packet_len_reg,
		output logic [7:0] data_to_tx_packet_reg,
		output logic [7:0] data_to_rx_packet_len_reg,
		output logic [7:0] data_to_rx_packet_reg,
		output logic [7:0] data_to_led,
		output logic [7:0] data_to_dac,
		output logic [7:0] data_to_fifo,
		output logic [7:0] data_to_fifo_length,
		output logic tx_en,
		input logic tx_rdy,
		input logic rx_rdy,
		input logic rx_n_rdy
		);

/* send data from master to slave 
0 == send data from master to the slave RW==0. write from host to target*/
assign rx_en_gpo = 			(addr_dv && rxdv && reg_addr==7'b0000000 && ~rw_out) ? 1'b1 : 1'b0;
assign rx_en_status = 		(addr_dv && rxdv && reg_addr==7'b0000001 && ~rw_out) ? 1'b1 : 1'b0;
assign input_en_tx_packet_len =(addr_dv && rxdv && reg_addr==7'b0000010 && ~rw_out) ? 1'b1 : 1'b0;
assign input_en_tx_packet = 	(addr_dv && rxdv && reg_addr==7'b0000011 && ~rw_out) ? 1'b1 : 1'b0;
assign input_en_rx_packet_len =(addr_dv && rxdv && reg_addr==7'b0000100 && ~rw_out) ? 1'b1 : 1'b0;
assign input_en_rx_packet = 	(addr_dv && rxdv && reg_addr==7'b0000101 && ~rw_out) ? 1'b1 : 1'b0;
assign rx_en_led = 			(addr_dv && rxdv && reg_addr==7'b0000110 && ~rw_out) ? 1'b1 : 1'b0;
assign rx_en_dac = (addr_dv && rxdv && reg_addr==7'b0000111 && ~rw_out) ? 1'b1 : 1'b0; // DAC register read
assign rx_en_fifo = (addr_dv && rxdv && reg_addr==7'b0001000 && ~rw_out) ? 1'b1 : 1'b0;
assign rx_en_fifo_length = (addr_dv && rxdv && reg_addr==7'b0001001 && ~rw_out) ? 1'b1 : 1'b0;

/* req data from slave (RW == 1, READ to host)*/
assign tx_en_gpo = 			(addr_dv && reg_addr==7'b0000000 && rw_out) ? 1'b1 : 1'b0;
assign tx_en_status = 		(addr_dv && reg_addr==7'b0000001 && rw_out) ? 1'b1 : 1'b0;
assign output_en_tx_packet_len =(addr_dv && reg_addr==7'b0000010 && rw_out) ? 1'b1 : 1'b0;
assign output_en_tx_packet = 	(addr_dv && reg_addr==7'b0000011 && rw_out) ? 1'b1 : 1'b0;
assign output_en_rx_packet_len =(addr_dv && reg_addr==7'b0000100 && rw_out) ? 1'b1 : 1'b0;
assign output_en_rx_packet = 	(addr_dv && reg_addr==7'b0000101 && rw_out) ? 1'b1 : 1'b0;
assign tx_en_led = 			(addr_dv && reg_addr==7'b0000110 && rw_out) ? 1'b1 : 1'b0;
assign tx_en_dac = 			(addr_dv && reg_addr==7'b0000111 && rw_out) ? 1'b1 : 1'b0; //DAC control
assign tx_en_fifo =       	(addr_dv && reg_addr==7'b0001000 && rw_out) ? 1'b1 : 1'b0;
assign tx_en_fifo_length =  (addr_dv && reg_addr==7'b0001001 && rw_out) ? 1'b1 : 1'b0;



always_comb 
	begin
		if (tx_en_gpo )
			begin
				tx_d = data_from_gpo;
				tx_en = 1'b1;
			end
		else if (tx_en_status)
			begin
				tx_d[7:0] = 8'b0000_0000 | (tx_rdy) << 7 | (rx_rdy & !rx_n_rdy) << 6;
				tx_en = 1'b1;
			end
		else if (output_en_tx_packet_len)
			begin
				tx_d = data_from_tx_packet_len_reg;
				tx_en = 1'b1;
			end
		else if (output_en_tx_packet)
			begin
				tx_d = data_from_tx_packet_reg;
				tx_en = 1'b1;
			end
		else if (output_en_rx_packet_len)
			begin
				tx_d = data_from_rx_packet_len_reg;
				tx_en = 1'b1;
			end
		else if (output_en_rx_packet)
			begin
				tx_d = data_from_rx_packet_reg;
				tx_en = 1'b1;
			end
		else if (tx_en_led)
			begin
				tx_d = data_from_led;
				tx_en = 1'b1;
			end
		else if (tx_en_dac)
			begin
				tx_d = data_from_dac;
				tx_en= 1'b1;
			end
		else if (tx_en_fifo)
			begin
				tx_d = data_from_fifo;
				tx_en = 1'b1;
			end
		else if (tx_en_fifo_length)
			begin
				tx_d = data_from_fifo_length;
				tx_en = 1'b1;
			end
		else
			begin
				tx_en = 1'b0;
				tx_d = 8'b0000_0000;
			end
	end
			
assign data_to_gpo = 		       (rx_en_gpo) ? rx_d : 8'b0000_0000;
assign data_to_status_reg =    	   (rx_en_status) ? rx_d : 8'b0000_0000;
assign data_to_tx_packet_len_reg = (input_en_tx_packet_len) ? rx_d : 8'b0000_0000;
assign data_to_tx_packet_reg =     (input_en_tx_packet) ? rx_d : 8'b0000_0000;
assign data_to_rx_packet_len_reg = (input_en_rx_packet_len) ? rx_d : 8'b0000_0000;
assign data_to_rx_packet_reg = 	   (input_en_rx_packet) ? rx_d : 8'b0000_0000;
assign data_to_led = 		       (rx_en_led) ? rx_d : 8'b0000_0000;
assign data_to_dac = 		       (rx_en_dac) ? rx_d : 8'b0000_0000;
assign data_to_fifo = 		   	   (rx_en_fifo) ? rx_d : 8'b0000_0000;
assign data_to_fifo_length = 	   (rx_en_fifo_length) ? rx_d : 8'b0000_0000;

endmodule : regwrap
