jaycordaro/WES207/teensy/tests/oqpsk/rf_cmd.ino

void rf_init()
{
  // reset
  RF_RST reset_cmd;
  reset_cmd.CMD = CHIP_RESET;
  spiWrite(reset_cmd.address, reset_cmd.value);

  // channel config
  spiWrite(RF09_IRQM::address, 0x1F);
  spiWrite(RF09_CS::address, 0x50);
  spiWrite(RF09_CCF0L::address, 0xF0);
  spiWrite(RF09_CCF0H::address, 0x8C);
  spiWrite(RF09_CNL::address, 0x01);
  spiWrite(RF09_CNM::address, 0x00);

  RF09_RXBWC rxbwc;
  rxbwc.BW = 8;
  rxbwc.IFS = 0;
  rxbwc.IFI = 0;
  spiWrite(rxbwc.address, rxbwc.value);

  delay(10);
  RF09_RXDFE rxdfe;
  rxdfe.SR = 1;
  rxdfe.RCUT = 0;
  //Serial.printf("value: %d\n", rxdfe.value);
  spiWrite(rxdfe.address, rxdfe.value);

  RF09_EDD edd;
  edd.DTB = 3;
  edd.DF = 4;
  spiWrite(edd.address, edd.value);

  spiWrite(RF09_RNDV::address, 0x11);
  
  RF09_TXCUTC txcutc;
  txcutc.PARAMP = 0;
  txcutc.LPFCUT = 0xB;
  spiWrite(txcutc.address, txcutc.value);

  RF09_TXDFE dfe;
  dfe.RCUT = 3;
  dfe.SR = 1;
  dfe.DM = 0;
  spiWrite(dfe.address, dfe.value);

  spiWrite(RF09_PAC::address, 0x7C);
  spiWrite(0x300, 0x1F);
  
  BBC0_PC pc0;
  pc0.CTX = 0;
  pc0.FCSFE = 0;
  pc0.FCSOK = 0;
  pc0.TXAFCS = 0;
  pc0.FCST = 1;
  pc0.BBEN = 1;
  pc0.PT = 0x3;
  spiWrite(pc0.address, pc0.value);

  BBC0_OQPSKC0 opqsk_c0;
  opqsk_c0.DM = 0;
  opqsk_c0.MOD = 0;
  opqsk_c0.FCHIP = 2;
  spiWrite(opqsk_c0.address, opqsk_c0.value);

  BBC0_OQPSKC1 opqsk_c1;
  opqsk_c1.RXO = 1;
  opqsk_c1.RXOLEG = 1;
  opqsk_c1.PDT0 = 1;
  opqsk_c1.PDT1 = 1;
  spiWrite(opqsk_c1.address, opqsk_c1.value);

  BBC0_OQPSKC2 opqsk_c2;
  opqsk_c2.SPC = 0;
  opqsk_c2.RPC = 0;
  opqsk_c2.ENPROP = 0;
  opqsk_c2.FCSTLEG = 1;
  opqsk_c2.RXM = 1;
  spiWrite(opqsk_c2.address, opqsk_c2.value);

  BBC0_OQPSKC3 opqsk_c3;
  opqsk_c3.HRLEG = 0;
  opqsk_c3.NSFD = 3;
  spiWrite(opqsk_c3.address, opqsk_c3.value);

  BBC0_OQPSKPHRTX tx;
  tx.LEG = 1;
  tx.MOD = 0;
  tx.PPDUT = 0;
  tx.RB0 = 0;
  spiWrite(tx.address, tx.value);

  BBC0_OQPSKPHRRX rx;
  rx.LEG = 1;
  rx.MOD = 0;
  rx.PPDUT = 0;
  rx.RB0 = 0;
  spiWrite(rx.address, rx.value);
}

void trx_off()
{
  RF09_CMD cmd;
  cmd.CMD = 0x2;
  spiWrite(cmd.address, cmd.value);

  delay(1);
}

void rx()
{
  RF09_CMD cmd;
  cmd.CMD = 0x5;
  spiWrite(cmd.address, cmd.value);

  delay(1);
}

void tx()
{
  RF09_CMD cmd;
  cmd.CMD = 0x3;
  spiWrite(cmd.address, cmd.value);

  delay(1);

  cmd.CMD = 0x4;
  spiWrite(cmd.address, cmd.value);
  delay(1);
  read_state();
}

void write_tx_length(uint16_t length)
{
  BBC0_TXFLH high;
  BBC0_TXFLL low;
  low.TXFLL = length & 0xFFFF;
  high.TXFLH = (length >> 8) & 0x07;
  spiWrite(high.address, high.value);
  spiWrite(low.address, low.value);
}

uint16_t read_tx_length()
{
  uint16_t ret = spiRead(BBC0_TXFLL::address);
  ret |= (spiRead(BBC0_TXFLH::address) & 0x07) << 8;
  return ret;
}

uint16_t read_rx_length()
{
  uint16_t ret = spiRead(BBC0_RXFLL::address);
  ret |= (spiRead(BBC0_RXFLH::address) & 0x07) << 8;
  return ret;
}

void read_rx()
{
  uint16_t length = read_rx_length();
  if(length == 0)
  {
    Serial.printf("No Rx\n");
    return;
  }

  Serial.printf("Rx packet len: %d\n", length);
  for(int i = 0; i < length; i++)
  {
    
    Serial.printf("[%d]: %d\n", i, spiRead(BBC0_FBRXS::address + i));
  }
}

void load_tx(int length)
{
  write_tx_length(length);
  Serial.printf("length: %d\n", read_tx_length());
  for(int i = 0; i < length; i++)
  {
    spiWrite(BBC0_FBTXS::address + i, i+1);
    //spiWrite(BBC0_FBTXS::address + i, 0xFF);
  }
}

void read_state()
{
  switch(spiRead(RF09_STATE::address))
  {
    case 0:
      Serial.println("Invalid (0)");
      break;
    case 1:
      Serial.println("Invalid (1)");
      break;
    case 2:
      Serial.println("TRXOFF");
      break;
    case 3:
      Serial.println("TXPREP");
      break;
    case 4:
      Serial.println("TX");
      break;
    case 5:
      Serial.println("RX");
      break;
    case 6:
      Serial.println("TRANSITION");
      break;
    case 7:
      Serial.println("RESET");
      break;
    default:
      Serial.println("UNKNOWN");
  }
}
