jaycordaro/WES207/(commit log)

2023-04-16 Added simulation for more stages in PCM to PDM conversion
2023-04-20 Added Teensy Opus tests
2023-04-22 initial teensy SPI test
2023-04-23 Added basic BPSK demodulator simulation w/o error tracking loops
    [encoder_test.ino]
2023-04-29 RF device SPI test
2023-04-30 1st RF pic by SPI
2023-05-01 AT86RF215 register table
    [Register Settings.xlsx]
2023-05-07 Checked in 1st version of Efinix RTL
    [WES207_basic.interface.csv, WES207_basic.pinout.csv, WES207_basic.res.csv, WES207_basic_io.csv]
2023-05-11 added TX LVDS, added Teensy-FPGA ICD
    TX LVDS using a 'canned' routine. Sends PN-15 zeros while tx_en asserted in register 7 (set bit 0 to '1' to turn tx_en on, set bit 0 to '0' to turn it off)
    registers added per Teensy-FPGA ICD but have not been piped yet
    moved LED, GPO registers so regs 4 and 5 freed up
2023-05-13 fix connection to lvds
    [WES207_basic.interface.csv, WES207_basic.pinout.csv, WES207_basic.res.csv]
2023-05-13 Changing SPI tester to use the second interface
2023-05-13 Setting file transceiver to use second SPI interface for FPGA
2023-05-14 Added FIFO to RTL and lowered SPI clock
    [WES207_basic.interface.csv, WES207_basic.pinout.csv, WES207_basic.res.csv]
2023-05-16 Added Tx and Rx FIFO, some SPI fixes
    [WES207_basic.interface.csv, WES207_basic.pinout.csv, WES207_basic.res.csv]
2023-05-18 FIFO loopback demo
    [WES207_basic.interface.csv, WES207_basic.pinout.csv, WES207_basic.res.csv]
2023-05-19 OQPSK print back command
2023-05-21 Use correct channels for OQPSK
    [opqsk.ino, rf_cmd.ino]
2023-05-27 combine FPGA SPI+ Atmel SPI
    * combine FPGA SPI + Atmel SPI
    * change Atmel CLKOUT to 32MHz
2023-06-02 RF folder clean up
    ..
    [Walkie_Talkie_Link_Budget_1st.xls, Walkie_Talkie_Link_Budget_2nd.xls, Walkie_Talkie_Link_Budget_2st.xls]
2023-06-02 OQPSK and audio upsample sims and teensy code
2023-06-02 teensy folder reorg
2023-06-02 RF folder readmes insertion
2023-06-03 SamplePlayer_1
    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
2023-06-03 matlab simulation of PDM polyphase filter
2023-06-04 fixed rx count issues
    [helper_functions.ino]
2023-06-04 reset on decoder failure
    [opus.ino]
2023-06-04 fix exit rx issue
    [opus.ino]
2023-06-06 Added header and CRC filter options
