jaycordaro/WES207/(notices)

Notices in the files:
rtl/WES207_basic/rtl/regwrap.sv:
copyright 2023 Jay Cordaro
